AdYaki102/lm2596adj-buck-converter/PCB.jpeg

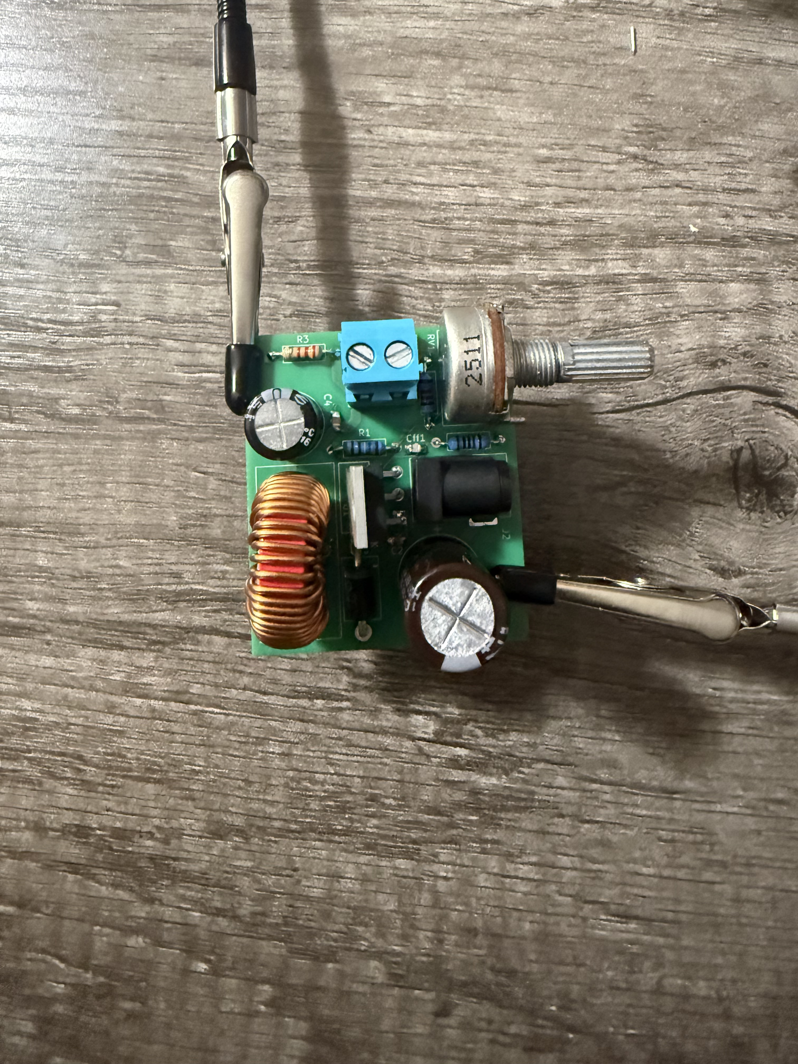
PCB.jpeg
