AdYaki102/lm2596adj-buck-converter/simulation/LM2596ADJ_24V_to_3,3_ to_20V_3A.asc

13.5kPOT: res2; {pot}
Cff: cap; 820p
Cin: polcap; 470µ; V=50 Rser=50m
Cout: polcap; 220µ; V=35 Rser=100m
D1: schottky; RBS5LAM40A
L1: ind; 100µ; Ipk=5 Rser=0.03
Load: res; {RLoad}
R1: res; 1k
RBleed: res; 2200
ResMin: res; 1.68k
S1: sw
U1: LM2596xx
V1: voltage; 24
V2: voltage; PULSE(0 1 5ms 1n 1n 5s 10s)
Named nets: 0, +VIN, OUT
.tran 0 20ms 0 1us
.inc LM2596XX.txt
.model SW SW(Ron=0.0001 Roff=1Meg Vt=0.5 Vh=0.1)
.meas TRAN Pin AVG (-V(+VIN)*I(V1)) FROM 15ms TO 20ms
.meas TRAN Pout AVG (V(out)*I(Load)) FROM 15ms TO 20ms
.meas TRAN Efficiency PARAM Pout/Pin
Switch model with a bleeder resistor to 
prevent voltage overshoot at low VOUT
3.3V-20V 3A LM2596ADJ 60W DC-DC Output Regulator
.param pot=0.1
.param RLoad=100
