AdYaki102/lm2596adj-buck-converter/(commit log)

2026-08-17 Attached gerber files
2026-09-09 PCB IRL picture
